heurstc/Chua-memcapacitor/kicad/signal_conditioning.kicad_sch

## KiCad design kicad/signal_conditioning.kicad_sch (2026-08-08)

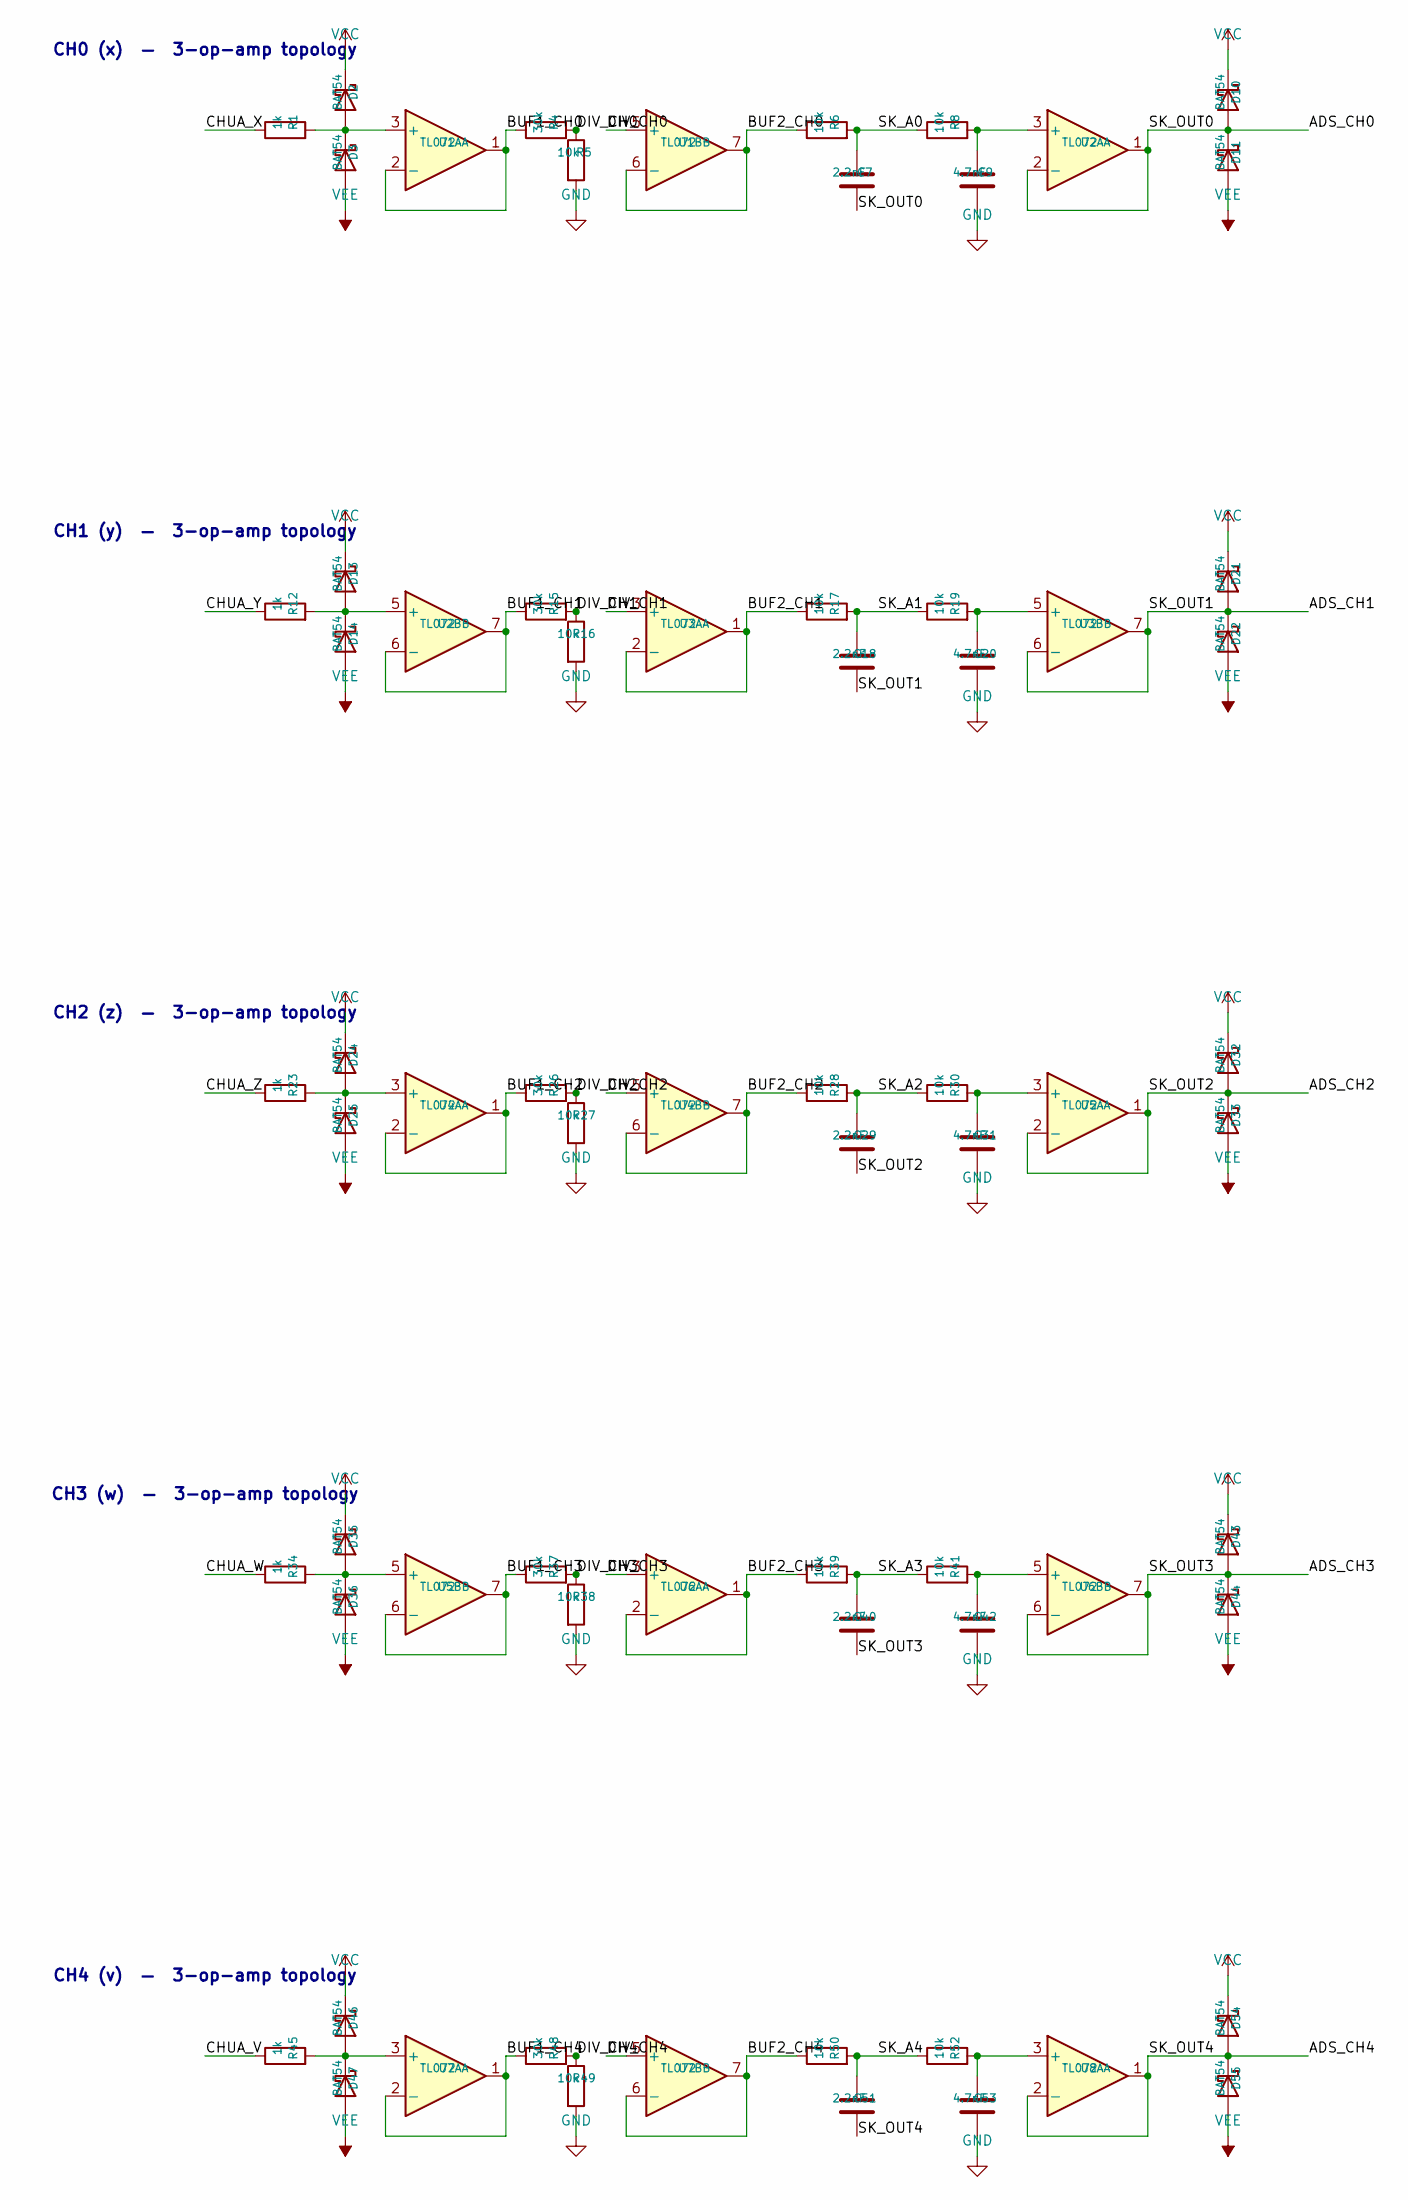
[picture p1: schematic signal_conditioning.kicad_sch]

Parts:
C7, C18, C29, C40, C51: 2.2nF; C_0402_1005Metric
C9, C20, C31, C42, C53: 4.7nF; C_0402_1005Metric
D2, D3, D10, D11, D13, D14, D21, D22, D24, D25, D32, D33, D35, D36, D43, D44, D46, D47, D54, D55: BAT54; D_SOD-323
R1, R12, R23, R34, R45: 1k; R_0402_1005Metric
R4, R15, R26, R37, R48: 30k; R_0402_1005Metric
R5, R6, R8, R16, R17, R19, R27, R28, R30, R38, R39, R41, R49, R50, R52: 10k; R_0402_1005Metric
U1A, U1B, U2A, U2B, U3A, U3B, U4A, U4B, U5A, U5B, U6A, U6B, U7A, U7B, U8A: TL072; SOIC-8_3.9x4.9mm_P1.27mm

Connections:
ADS_CH0: C7.2, D10.2 (A), D11.1 (K), U2A.1, U2A.2 (-)
ADS_CH1: C18.2, D21.2 (A), D22.1 (K), U3B.6 (-), U3B.7
ADS_CH2: C29.2, D32.2 (A), D33.1 (K), U5A.1, U5A.2 (-)
ADS_CH3: C40.2, D43.2 (A), D44.1 (K), U6B.6 (-), U6B.7
ADS_CH4: C51.2, D54.2 (A), D55.1 (K), U8A.1, U8A.2 (-)
BUF1_CH0: R4.1, U1A.1, U1A.2 (-)
BUF1_CH1: R15.1, U2B.6 (-), U2B.7
BUF1_CH2: R26.1, U4A.1, U4A.2 (-)
BUF1_CH3: R37.1, U5B.6 (-), U5B.7
BUF1_CH4: R48.1, U7A.1, U7A.2 (-)
BUF2_CH0: R6.1, U1B.6 (-), U1B.7
BUF2_CH1: R17.1, U3A.1, U3A.2 (-)
BUF2_CH2: R28.1, U4B.6 (-), U4B.7
BUF2_CH3: R39.1, U6A.1, U6A.2 (-)
BUF2_CH4: R50.1, U7B.6 (-), U7B.7
CHUA_V: R45.1
CHUA_W: R34.1
CHUA_X: R1.1
CHUA_Y: R12.1
CHUA_Z: R23.1
DIV_CH0: R4.2, R5.1, U1B.5 (+)
DIV_CH1: R15.2, R16.1, U3A.3 (+)
DIV_CH2: R26.2, R27.1, U4B.5 (+)
DIV_CH3: R37.2, R38.1, U6A.3 (+)
DIV_CH4: R48.2, R49.1, U7B.5 (+)
GND: C9.2, C20.2, C31.2, C42.2, C53.2, R5.2, R16.2, R27.2, R38.2, R49.2
unnamed: C9.1, R8.2, U2A.3 (+)
unnamed: C20.1, R19.2, U3B.5 (+)
unnamed: C31.1, R30.2, U5A.3 (+)
unnamed: C42.1, R41.2, U6B.5 (+)
unnamed: C53.1, R52.2, U8A.3 (+)
unnamed: D2.2 (A), D3.1 (K), R1.2, U1A.3 (+)
unnamed: D13.2 (A), D14.1 (K), R12.2, U2B.5 (+)
unnamed: D24.2 (A), D25.1 (K), R23.2, U4A.3 (+)
unnamed: D35.2 (A), D36.1 (K), R34.2, U5B.5 (+)
unnamed: D46.2 (A), D47.1 (K), R45.2, U7A.3 (+)
SK_A0: C7.1, R6.2, R8.1
SK_A1: C18.1, R17.2, R19.1
SK_A2: C29.1, R28.2, R30.1
SK_A3: C40.1, R39.2, R41.1
SK_A4: C51.1, R50.2, R52.1
VCC: D2.1 (K), D10.1 (K), D13.1 (K), D21.1 (K), D24.1 (K), D32.1 (K), D35.1 (K), D43.1 (K), D46.1 (K), D54.1 (K)
VEE: D3.2 (A), D11.2 (A), D14.2 (A), D22.2 (A), D25.2 (A), D33.2 (A), D36.2 (A), D44.2 (A), D47.2 (A), D55.2 (A)

Notes on the sheet:
CH0 (x) — 3-op-amp topology
CH1 (y) — 3-op-amp topology
CH2 (z) — 3-op-amp topology
CH3 (w) — 3-op-amp topology
CH4 (v) — 3-op-amp topology
