heurstc/Chua-memcapacitor/(commit log)

2026-08-07 Add 5D chaos monitor: RP2350 firmware, host capture/plot, signal conditioning
    Full system for streaming 5-channel Chua attractor data at 12 kHz/ch to Linux
    over USB CDC using XIAO RP2350 + two ADS1262 32-bit ADCs.
    Firmware (Core 0/Core 1 split, lock-free SPSC ring buffer, TinyUSB CDC):
    - ADS1262 SPI driver with SINC1 filter for single-cycle mux settling
    - 14-byte framed packets with XOR checksum and sequence numbers
    Host (Python, three-thread architecture):
    - PacketParser serial reader, ChannelBuffer circular numpy arrays
    - Real-time 3D attractor + 2D projection plots via FuncAnimation
    Signal conditioning (KiCad 7 schematic + ngspice SPICE + BOM):
    - Rev 2: 3-op-amp topology per channel (i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
    [bom.csv, signal_conditioning.kicad_sch]
2026-08-07 Fix KiCad parse error: pin_numbers hide syntax
    KiCad 7 expects bare token 'hide' not '(hide yes)' for pin_numbers
    in lib_symbols. Fixes 'Expecting hide' error on schematic load.
    [signal_conditioning.kicad_sch]
2026-08-07 Fix lib_symbols: remove exclude_from_sim from symbol definitions
    exclude_from_sim is not valid inside lib_symbols in KiCad 7.0.x,
    causing a parse error on schematic load. Valid only at instance level.
    [signal_conditioning.kicad_sch]
2026-08-07 Fix KiCad syntax: replace (hide yes) with bare hide token throughout
    KiCad 7 expects the bare token 'hide' inside effects blocks,
    not '(hide yes)'. Affected all 27 property hide declarations.
    [signal_conditioning.kicad_sch]
2026-08-07 Fix KiCad syntax: bold token in font effects
    KiCad 7 expects bare 'bold' token inside font block, not '(bold yes)'.
    Omit entirely when not bold.
    [signal_conditioning.kicad_sch]
2026-08-07 Fix KiCad syntax: fields_autoplaced is a bare flag, no value
    [signal_conditioning.kicad_sch]
2026-08-07 Fix KiCad syntax: remove exclude_from_sim from symbol instances
    Not valid at instance level in KiCad 7.0.x.
    [signal_conditioning.kicad_sch]
2026-08-07 Fix wire stroke type: use solid instead of default
    [signal_conditioning.kicad_sch]
2026-08-07 Fix UUID format and label syntax to match KiCad 7 reference format
    - UUIDs must not be quoted: (uuid abc...) not (uuid "abc...")
    - Labels: remove InterSheetRef property, inline fields_autoplaced
    - All 6 primitive functions updated
    [signal_conditioning.kicad_sch]
2026-08-07 kicad: Rev 3 schematic generator — strict 1.27mm grid alignment
    All wire endpoints now verified on 1.27mm KiCad snap grid; labels placed
    at exact pin/junction coordinates instead of 0.5mm stubs. op-amp outputs
    connect directly at y_rail with no off-grid intermediate points.
    [signal_conditioning.kicad_sch]
2026-08-07 kicad: fix TL072 embedded symbol sub-unit names
    Renaming LM2904 → Amplifier_Operational:TL072 must also rename the inner
    sub-units (LM2904_1_1 → Amplifier_Operational:TL072_1_1, etc.) or KiCad
    rejects the schematic with 'invalid symbol unit name prefix'.
    [signal_conditioning.kicad_sch]
2026-08-07 kicad: fix TL072 sub-unit naming — base name only, no lib prefix
    KiCad requires inner sub-units as TL072_1_1 not
    Amplifier_Operational:TL072_1_1 — library prefix only applies to the
    outer symbol declaration.
    [signal_conditioning.kicad_sch]
2026-08-07 kicad: fix embedded lib_symbols outer names — add lib: prefix
    Symbols embedded in lib_symbols must use "Device:R", "power:GND" etc.
    to match the lib_id used in placements; bare "R", "GND" caused all
    components to render as ? blocks.
    [signal_conditioning.kicad_sch]
2026-08-08 kicad: fix power symbol orientation — VEE mirror x, GND angle 0
    VEE symbols now use (mirror x) so they point downward for negative
    supply, matching KiCad convention. GND changed from angle=270 to 0.
    Also adds U-shaped unity-gain feedback wires (out→down→left→up to -in)
    replacing the invisible net-label stubs.
2026-08-08 kicad: push hand-edited schematic with full routing
    KiCad-edited version: VEE symbols mirrored, GND corrected, unity-gain
    feedback wires routed, labels repositioned above signal rail.
    [signal_conditioning.kicad_sch]
2026-08-08 Add BOM with correct Rev 3 reference designators and IC unit assignments
    83 components: 25R, 30C, 20D (BAT54 SOD-323), 8×TL072 SOIC-8.
    Includes filter design parameters (fn≈4.95kHz, Q=0.731, ÷4 attenuation).
    Also unblock kicad/bom.csv from *.csv gitignore rule.
    [bom.csv]
2026-08-08 Add printable BOM PDF and source HTML for signal_conditioning Rev 3
    A4-formatted, table-per-category layout with IC unit assignments,
    filter design parameters, and X7R/C0G usage notes.
